zimmcl/EDII_TPFinal/Informe_Final.pdf

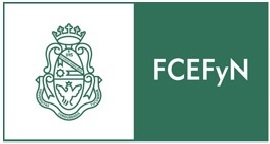
[picture p1: figure]

FA C U LTA D D E C I E N C I A S E X A C TA S ,

### F Í S I C A S Y N AT U R A L E S

E L E C T R Ó N I C A D I G I TA L 2

## C O N T R O L D E P R O X I M I D A D

## M E D I A N T E U S O D E S E N S O R U LT R A S Ó N I C O H C - S R 0 4

## Zimmel Ceccón, Ezequiel José

### email ezequielzimmel@gmail.com

## Docente: Ing. Martín Ayarde

Ú LTM A R E V I S I Ó N : 1 7 D E J U N I O D E 2 0 1 8

## I N F O R M E T R A B A J O F I N A L

índice
1. Descripción general | 3
2. Desarrollo | 4

abstract

Hoy en día existen numerosos dispositivos que utilizan ultrasonidos, tanto en el área industrial, como el la medicina y muchas otras aplicaciones no tan conocidas. En este proyecto vamos a explorar las posibilidades del sensor HC-SR04, un sensor ultrasónico de distancia de bajo costo, usado comúnmente en robots, pero no necesariamente limitado a ese uso. En el circuito de prueba del proyecto utilizaremos un microcontrolador PIC16F887 que medirá el tiempo del pulso ECHO. Después calcularemos la distancia y se mostrará a través de diplays 7-SEG. A su vez, la misma información será transmitida por serie a un ordenador.
El documento desarrolla todas las instancias necesarias para lograr implementar un proyecto empleando microcontroladores PIC. Las instancias del documento abarcan desde el detallado de los elementos a emplear, pasando por la grabación del microcontrolador, hasta la muestra del proyecto montado y funcionando sobre una protoboard.

Ingeniería en Computación, Universidad Nacional de Córdoba, Córdoba, Argentina

2

descripción general | 3
1 | descripción general

## 1.1 Introducción

Los sensores ultrasónicos modernos para la medición de distancias, son de bajo costo y permiten su acoplamiento a sistemas microcontroladores. Estos sensores cuentan con una pequeña bocina emisora del sonido y un micrófono receptor de la señal ultrasónica rebotada por el objeto del cual se desea medir la distancia.
El principio de funcionamiento es el siguiente: a través de la bocina se envían trenes de pulsos de ultrasonido a una frecuencia 40Khz. Esta señal rebota contra el objeto y regresa al sensor, siendo detectada por el micrófono (Figura 1). La distancia se calcula considerando el tiempo (en microsegundos) del ancho del pulso de la señal Echo, y dividida por 58 para obtener el valor en centimetros.

Distancia[cm] = AnchodelpulsoEcho[µs]
58 | (1)

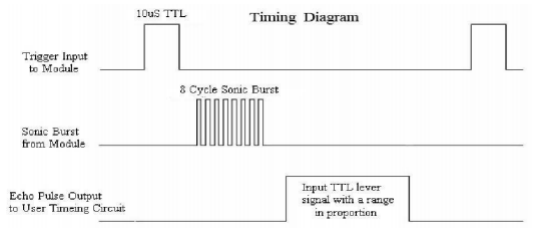
[picture p2: figure]

Figura 1: Funcionamiento

El sensor HC-SR04, (https://cdn.sparkfun.com/datasheets/Sensors/Proximity/HCSR04.pdf) con capacidad de medir distancias entre 2 cms y 4 metros, maneja 2 señales de control conectadas al microcontrolador, en este caso el PIC16F887. La primera es el ’Trigger’, que es un pulso con 10µs (mínimo) de duración que dispara la emisión de 8 pulsos de ultrasonido a través de la bocina, como se muestra en la Figura 1. La segunda señal, llamada ’Echo’, genera un pulso cuya duración es igual al tiempo de respuesta de la señal ultrasónica rebotada por el objeto a medir.

## 1.2 Elementos empleados

Para el desarrollo del proyecto se precisa el uso de:

- Programador PIC y software PICkit con soporte para el microcontrolador.
- Microcontrolador PIC16F887. (http://ww1.microchip.com/downloads/en/DeviceDoc/41291D.pdf)
- Protoboard(s).
- 1 Buzzer piezoelectrico. Hoja de datos. (http://www.farnell.com/datasheets/2171929.pdf)
- 1 sensor ultrasónico HC-SR04. Hoja de datos. (https://docs.google.com/document/d/1Y-yZnNhMYy7rwhAgyL_pfa39RsB-x2qR4vP8saG73rE/edit)
- 3 pulsador Switch.
- Resistencias varias.
- 2 diplay 7-SEG x4 Anodo Común. Hoja de datos. (http://kitsrus.com/pdf/kw4-561.pdf)
- 6 transistores PNP de baja señal. Hoja de datos. (https://www.onsemi.com/pub/Collateral/BC327-D.PDF)
- 1 LED RGB. Hoja de datos. (https://www.kitronik.co.uk/pdf/5mm_RGB_led_common_cathode.pdf)
- 1 módulo USB-UART CP2102. Hoja de datos. (https://www.sparkfun.com/datasheets/IC/cp2102.pdf)

desarrollo | 4
2 | desarrollo

En esta sección se describirá lo que se espera que el sistema haga (Requerimientos), y como fueron implementados dichos requerimientos (Especificaciones). A su vez, se detallaran los cálculos de los elementos pasivos del circuito, y se abordan los pasos necesarios para la grabación del microcontrolador.

## 2.1 Requerimientos y Especificaciones

A partir del siguiente diagrama funcional, se desarrollan las correspondientes subsecciones.

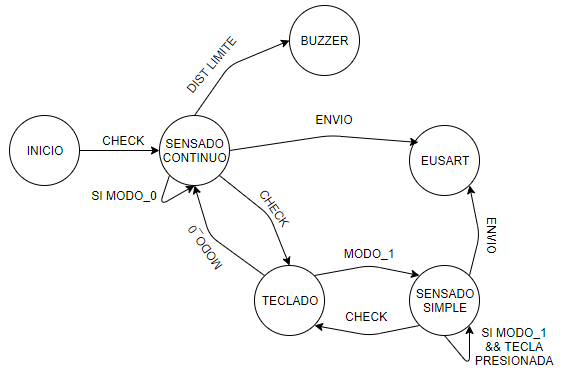
[picture p3: figure]

Figura 2: Funcionamiento

### 2.1.1 Sensado de distancia

Para la adquisición de la distancia se emplea la ecuación 1, mediante el uso de interrupciones por RB0 y TMR0.
Lo primero que se hace es realizar la configuración del registro INTCON (Interrupciones) y OPTION_REG (Flanco de interrupción de RB0 y PS).
MOVLW | B’1 1 0 1 0 0 0 0 ’
MOVWF | OPTION_REG | ; RB0 | por fl a n c o ascenden te . PS 1 : 2
MOVLW | B’1 0 0 1 0 0 0 0 ’
MOVWF | INTCON | ; GIE (ON) , T0IE (OFF ) , INTE (ON)

Se elige interrumpir RB0 por flanco ascendente para detectar el frente del pulso ECHO. A partir de esta interrupción, se inicializa el TMR0 y se habilita dicha interrupción, a los fines de contabilizar los centimetros de distancia al objetivo. Por otro lado, el flanco de interrupción de RB0 se cambia a flanco descendiente, para detectar la cola del pulso ECHO, y a partir de dicho instante deshabilitar la interrupción por TMR0.
Las interrupciones son gestionadas por el vector de interrupción, en donde se chequean las banderas de las interrupciones y se redirecciona a la subrutina de atención correspondiente.

INT_VECTOR
| ; Guardamos el c on te x t o
MOVLW | W_TEMP
SWAPF | STATUS,W
MOVWF | S_TEMP

; Chequeamos banderas de i n t e r r u p ci o n
BTFSC | INTCON, INTF
CALL | RB0_INT
BTFSC | INTCON, T0IF
CALL | TMR0_INT
; Recuperamos el c on te x t o
SWAPF | S_TEMP ,W
MOVWF | STATUS
SWAPF | W_TEMP, F
SWAPF | W_TEMP,W
RETFIE

La subrutina de RB0 chequea el estado actual del Pin de entrada al microcontrolador desde el Pin ECHO del sensor. Si el estado es Alto (1 lógico), inicializa el TMR0, habilita su interrupción y cambia su flanco de interrupción pasando de flanco ascendente a descendente. Por el contrario, si el estado es Bajo (0 lógico), deshabilita el TMR0 y cambia su flanco de interrupción de descendente a ascendente.

RB0_INT
BCF | INTCON, INTF
BTFSS | ECO
GOTO | DETENER_TIMER
; Cargo al TMR0 | para i n t e r r u p ci o n de 58us
MOVLW | . 1 9 8
MOVWF | TMR0
; Habili tamos ( i n i c i a ) el TMR0
BSF INTCON, T0IE
; Reseteamos l o s r e g i s t r o s a s o ci ad o s a l o s di s pl a y s
CLRF | UNIDADES
CLRF | DECENAS
CLRF | CENTENAS
; A c ti v a ci on de RB0 | por fl a n c o de scendien te
BANKSEL OPTION_REG
BCF OPTION_REG, 6
BANKSEL PORTA
RETURN
DETENER_TIMER
; Se de ti ne al TMR0
BCF INTCON, T0IE
; Se le v a n t a l a bandera de ad q ui si ci o n de di s t a n ci a
BSF | ECO_DONE
; A c ti v a ci on de RB0 | por fl a n c o ascenden te
BANKSEL OPTION_REG
BSF OPTION_REG, 6
BANKSEL PORTA
RETURN

Con cada interrupción del TMR0 se incrementan, según correspondan, los registros asociados al almacenaje de la distancia sensada. El valor de carga del TMR0 garantiza que se produzcan interrupciones cada 58µs. El valor se obtiene a partir
del siguiente cálculo: 58µs = | 4

Fosc ∗ (256 − Carga) ∗ PS =

4
8MHz ∗ (256 − 198) ∗ 2

Nota: Los cálculos anteriores son teóricos, en la práctica se ajusto el valor de Carga para mayor exactitud en la medición.

TMR0_INT
BCF | INTCON | , T0IF

MOVLW | . 1 9 8
MOVWF | TMR0
INCF | UNIDADES
MOVLW | 0x0A
SUBWF | UNIDADES,W
BTFSS | STATUS, Z
RETURN
CLRF | UNIDADES
INCF | DECENAS
MOVLW | 0x0A
SUBWF | DECENAS,W
BTFSS | STATUS, Z
RETURN
CLRF | DECENAS
INCF | CENTENAS
MOVLW | 0x0A
SUBWF | CENTENAS,w
BTFSS | STATUS, Z
RETURN
CLRF CENTENAS
RETURN

### 2.1.2 Seteo de distancia máxima

El seteo de la distancia máxima permite al usuario definir la distancia a partir de la cual el sistema dejará de activar la alerta visual y sonora de proximidad. Esto es llevado a cabo por la rutina de chequeo de botones, y en función de que boton es accionado los registros que almacenan la distancia máxima son incrementado o disminuidos.

CHECK_BOTON
BTFSC | PORTD, RD5
GOTO | RD_5
BTFSC | PORTD, RD6
GOTO | RD_6
BTFSC | PORTD, RD7
GOTO | RD_7
RETURN
RD_5
BTFSC | PORTD, RD5
GOTO | RD_5
BSF | SIN_SHOT
RETURN
RD_6
BTFSC | PORTD, RD6
GOTO | RD_6
INCF | MD_UNI, F
BCF | DEC_FLAG, 0
MOVLW | . 1 0
XORWF | MD_UNI,W
BTFSS | STATUS, Z
RETURN
CLRF | MD_UNI
INCF | MD_DEC, F
BCF | DEC_FLAG, 1
MOVLW | . 1 0

XORWF | MD_DEC,W
BTFSS | STATUS, Z
RETURN
CLRF | MD_DEC
INCF | MD_CEN, F
BCF | DEC_FLAG, 2
MOVLW | . 1 0
XORWF | MD_CEN,W
BTFSS | STATUS, Z
RETURN
CLRF CENTENAS
RETURN

RD_7
BTFSC | PORTD, RD7
GOTO | RD_7
BTFSC | DEC_FLAG, 0
RETURN
MOVF | MD_UNI,W
XORLW | . 0
BTFSC | STATUS, Z
GOTO | CHECK_DEC
DECF | MD_UNI, F
RETURN

CHECK_DEC
BTFSC | DEC_FLAG, 1
GOTO | CLR_MD_UNI
MOVLW | . 9
MOVWF | MD_UNI
DECF | MD_DEC, F
MOVLW | 0xFF
XORWF | MD_DEC,W
BTFSS | STATUS, Z
RETURN
BTFSC | DEC_FLAG, 2
GOTO | CLR_MD_DEC
MOVLW | . 9
MOVWF | MD_DEC
DECF | MD_CEN, F
MOVLW | 0xFF
XORWF | MD_CEN,W
BTFSS | STATUS, Z
RETURN
CLR_MD_CEN
BSF | DEC_FLAG, 2
MOVLW | 0x00
MOVWF | MD_CEN
MOVWF | MD_DEC
MOVWF | MD_UNI
RETURN
CLR_MD_DEC
BSF | DEC_FLAG, 1
MOVLW | 0x00
MOVWF | MD_UNI

MOVWF MD_DEC
RETURN
CLR_MD_UNI
BSF | DEC_FLAG, 0
MOVLW | 0x00
MOVWF | MD_UNI
RETURN

### 2.1.3 Despliegue de datos por displays 7-SEG

La multiplexación de los displays 7-SEG, permite mostrar la distancia sensada y la distancia máxima configurada por el usuario. Los valores almancenados en los registros de distancia se encuentran en BCD por lo que, mediante una tabla de conversión, se obtiene el correspondiente valor 7-SEG. A su vez, la subrutina de RETARDO garantiza que el tiempo que permanece encendido cada display, simule que estan todos encendidos.

MOSTRAR
MOVLW | b ’0 0 1 1 1 0 0 0 ’
MOVWF | PORTB
MOVLW | UNIDADES
MOVWF | FSR
MOVF | INDF ,W
CALL | CONVIERTE
BCF | PORTB, 5
MOVWF | PORTA
CALL | RETARDO
BSF | PORTB, 5
INCF | FSR
MOVF | INDF ,W
CALL | CONVIERTE
BCF | PORTB, 4
MOVWF | PORTA
CALL | RETARDO
BSF | PORTB, 4
INCF | FSR
MOVF | INDF ,W
CALL | CONVIERTE
BCF | PORTB, 3
MOVWF | PORTA
CALL | RETARDO
BSF | PORTB, 3
INCF | FSR
MOSTRAR_MD
MOVF | INDF ,W
CALL | CONVIERTE
BCF | PORTC, 5
MOVWF | PORTA
CALL | RETARDO
BSF | PORTC, 5
INCF | FSR
MOVF | INDF ,W
CALL | CONVIERTE
BCF | PORTC, 4
MOVWF | PORTA
CALL | RETARDO
BSF | PORTC, 4

INCF | FSR
MOVF | INDF ,W
CALL | CONVIERTE
BCF | PORTC, 3
MOVWF | PORTA
CALL | RETARDO
BSF | PORTC, 3
RETURN

### 2.1.4 Cambio entre modos de uso

Cuando se preciona la tecla correspondiente (RD5), se pone en 1 la bandera del ’Modo Simple’, que será chequeada en el bloque de rutina principal, accediendo a la rutina SINGLE_SHOT. En esta rutina se habilitan 2 botones, el primero permite hacer una medición de distancia, y el otro pone en 0 la bandera del ’Modo Simple’, recupera el estado previo a este modo y continua con la ejecución contínua del sistema.

SINGLE_SHOT
MOVF | MD_UNI,W
MOVWF | MD_UNI_C
MOVF | MD_DEC,W
MOVWF | MD_DEC_C
MOVF | MD_CEN,W
MOVWF | MD_CEN_C
ESPERA
MOVLW | . 1 0
MOVWF | MD_UNI
MOVWF | MD_DEC
MOVWF | MD_CEN
MOVLW | MD_UNI
MOVWF | FSR
CALL | MOSTRAR_MD
BTFSC | PORTD, RD7
CALL | DISPARO_
BTFSS | PORTD, RD5
GOTO | ESPERA

SALIR_
BTFSC | PORTD, RD5
GOTO | SALIR_
MOVLW | UNIDADES
MOVWF | FSR
MOVF | MD_UNI_C,W
MOVWF | MD_UNI
MOVF | MD_CEN_C,W
MOVWF | MD_CEN
MOVF | MD_DEC_C,W
MOVWF | MD_DEC
BCF | SIN_SHOT
RETURN
DISPARO_
CALL | SENSADO
BTFSC | PORTD, RD7
CALL | MOSTRAR
BTFSC | PORTD, RD7
GOTO | $−3

CALL ENVIAR
RETURN

### 2.1.5 Aviso de proximidad al objeto sensado

Se realiza la comparación, en binario, de la distancia sensada y el valor de distancia máximo ingresado por el usuario. Si la distancia sensada es mayor al máximo, el sistema desactiva todo tipo de alerta (OFF_); en caso contrario, procede de la siguiente manera:

- Calcula el Rango de distancia, haciendo la diferencia entre el valor máximo ingresado por el usuario y un valor mínimo prefijado (en nuestro caso 5).
- A partir del Rango y con un valor prefijado de cantidad de intervalos (en nuestro caso 5), calcula el intervalo menor (representando unidades de distancia [cm]), a partir del cual, mediante suma de si mismo, obtiene los restante puntos de corte. Ej: Si tenemos que la distancia máxima es 50[cm], tendríamos que Rango=(50 − 5)=45[cm], luego el intervalo mínimo es 9[cm], quedando los puntos de corte en [9, 18, 27, 36, 45].
- Con los puntos de cortes ya definidos, se procede a comprar la distancia sensada con cada nivel de corte. Si la distancia es mayor al primer nivel de corte (según ejemplo 9[cm]), se procede a comprar con el segundo nivel de corte (según ejemplo 18[cm]), continuando hasta el último punto de corte. Siguiendo con el ejemplo, en caso de que la distancia sensada sea mayor a 18[cm] pero menor a 27[cm], el sistema accede a una subrutina asociada a ese intervalo, en donde se setean los valores de RETARDO y se activa la correspondiente alerta visual.

COMPARAR_DISTANCIA
CALL | BCD2BIN
MOVF | BCD_CONV,W
SUBWF | MD_BCD_C,W
BTFSS | STATUS, C
GOTO | OFF_
MOVLW | . 5
SUBWF | MD_BCD_C,W
MOVWF | RANGO
MOVWF | TEMP
INCF | INTERVALO, F
MOVLW | . 5
SUBWF | TEMP, F
BTFSC | STATUS, C
GOTO | $−4
DECF | INTERVALO, F
MOVF | INTERVALO,W
ADDLW | . 8
MOVWF | TEMP
MOVLW | . 8
SUBWF | BCD_CONV,W
BTFSS | STATUS, C
GOTO | NIV_5
MOVF | BCD_CONV,W
SUBWF | TEMP,W

BTFSC | STATUS, C
GOTO | NIV_4
MOVF | INTERVALO,W
ADDWF | TEMP, F
MOVF | BCD_CONV,W
SUBWF | TEMP,W
BTFSC | STATUS, C
GOTO | NIV_3
MOVF | INTERVALO,W
ADDWF | TEMP, F
MOVF | BCD_CONV,W
SUBWF | TEMP,W
BTFSC | STATUS, C
GOTO | NIV_2
MOVF | INTERVALO,W
ADDWF | TEMP, F
MOVF | BCD_CONV,W
SUBWF | TEMP,W
BTFSC | STATUS, C
GOTO | NIV_1
MOVF | INTERVALO,W
ADDWF | TEMP, F
MOVF | BCD_CONV,W
SUBWF | TEMP,W
BTFSC | STATUS, C
GOTO | NIV_0

OFF_
BCF | BUZZER
BCF | LED_B
BCF | LED_R
BCF | LED_G
RETURN

NIV_5
BANKSEL PORTC
BSF | BUZZER
BSF | LED_R
RETURN
NIV_4
BANKSEL PORTC
BSF | LED_R
BCF | LED_G
BCF | LED_B
MOVLW | . 1 0
MOVWF | SUP
GOTO | CARGAR_RES
NIV_3
BANKSEL PORTC
BSF | LED_G
BCF | LED_B
BCF | LED_R

MOVLW | . 3 0
MOVWF | SUP
GOTO | CARGAR_RES
NIV_2
BANKSEL PORTC
BSF | LED_G
BCF | LED_B
BCF | LED_R
MOVLW | . 5 0
MOVWF | SUP
GOTO | CARGAR_RES
NIV_1
BANKSEL PORTC
BSF | LED_B
BCF | LED_R
BCF | LED_G
MOVLW | . 7 0
MOVWF | SUP
GOTO | CARGAR_RES
NIV_0
BANKSEL PORTC
BSF | LED_B
BCF | LED_R
BCF | LED_G
MOVLW | . 9 0
MOVWF | SUP
GOTO | CARGAR_RES

CARGAR_RES
MOVLW | . 2 6
MOVWF | MED
MOVLW | . 6 9
MOVWF | INT
CLRF | TEMP
CLRF | INTERVALO
BTFSC | BUZZER
GOTO | SWITCH
BSF | BUZZER
CALL | RETARDO
CALL | RETARDO
RETURN
SWITCH
MOVLW | 0xF8
ANDWF | PORTC
BCF | BUZZER
CLRF | TEMP
CLRF | INTERVALO
CALL | RETARDO_BUZ
RETURN

### 2.1.6 Envío de datos a PC mediante comunicación serie

Lo primero es configurar el periférico para la comunicación. Se realiza una comunicación de 8bits, asíncrona y de alta velocidad (registro TXSTA). Luego se carga el registro SPBRG con un valor que permita, en nuestro caso, un Baud Rate de 9600 considerando que la frecuencia del oscilador está configurada a 8MHz. Dicho valor puede obtenerse mediante tablas simunistradas por el fabricante o mediante la siguiente ecuación:

X =

Fosc
16 ∗ BaudRateDeseado − 1 =

8MHz
16 ∗ 9600 − 1 = 51
; 9 6 0 0 | baudios con Fosc 8MHz
MOVLW | . 5 1
MOVWF | SPBRG
MOVLW | B’0 0 1 0 0 1 0 0 ’
MOVWF | TXSTA

; Cambiar de banco
;BRG 8 b i t s
BCF BAUDCTL, BRG16

Realizada la configuración, solo resta llamar a la subrutina ENVIAR, para transmitir los datos desde el microcontrolar hacia la PC. Durante la transmisión se hace una espera activa hasta que el registro TXREG se vacie, garantizando que la totalidad de los bits fueron transmitidos.

ENVIAR_DATO_TX
BANKSEL TXREG
MOVWF | TXREG
BSF | STATUS, RP0
; Chequeo TSR , espero a que se v a ci e ( 0 )
BTFSS | TXSTA,TRMT
GOTO | $−1
BCF | STATUS, RP0
RETURN

## 2.2 Grabación del PIC

Para realizar la programación se uso la herramienta PICkit 2 y se mapearon los pines entre el programador y el PIC16F887 conforme a la siguiente imagen:

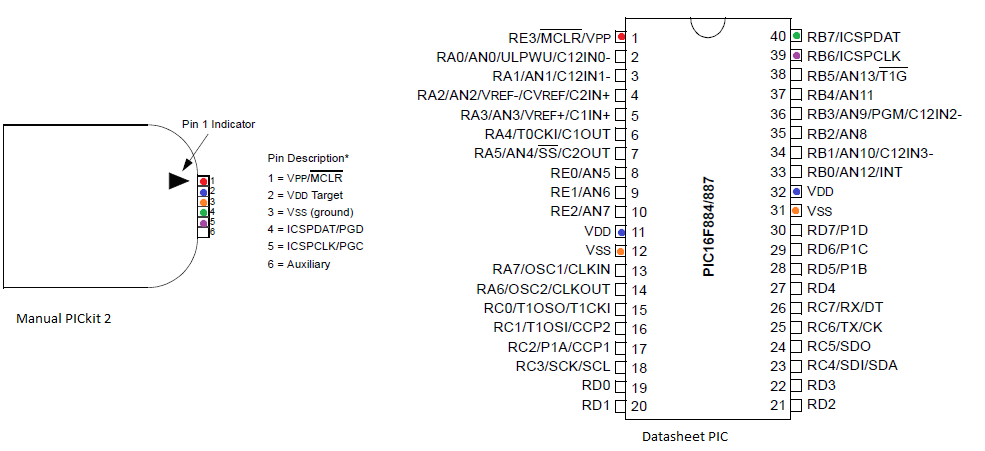
[picture p4: figure]

Figura 3: Mapeo de pines.

Para alimentar al PIC hay que usar solo un par de pines VDD y VSS.

Una vez conectado el programador y ya en la herramienta del PICkit, elegimos el disposito(PIC16F887) y seleccionamos la opción de importación del archivo .hex y grabación.

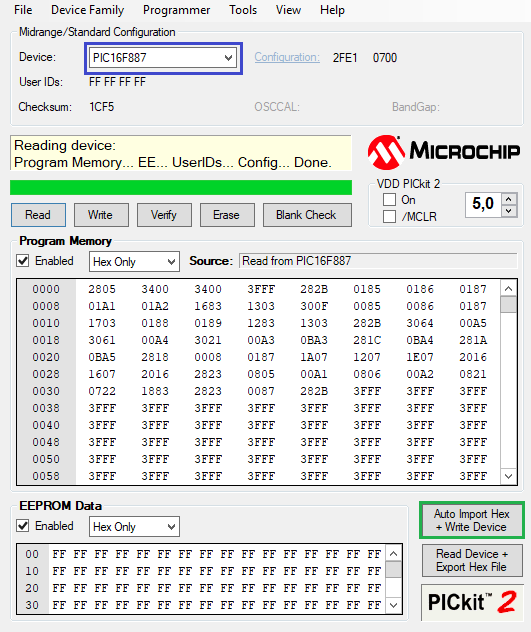
[picture p5: figure]

Figura 4: Grabación del microcontrolador.

## 2.3 Implementación

### 2.3.1 Simulación

A los fines de probar si el código desarrollado cumple con los requerimientos, se implemento todo el circuito empleando la herramienta Proteus. Con el documento se adjunta el archivo .pdsprj del simulador.
La siguiente figura muestra como se disponen e interconectan los diversos elementos que conforman el circuito.

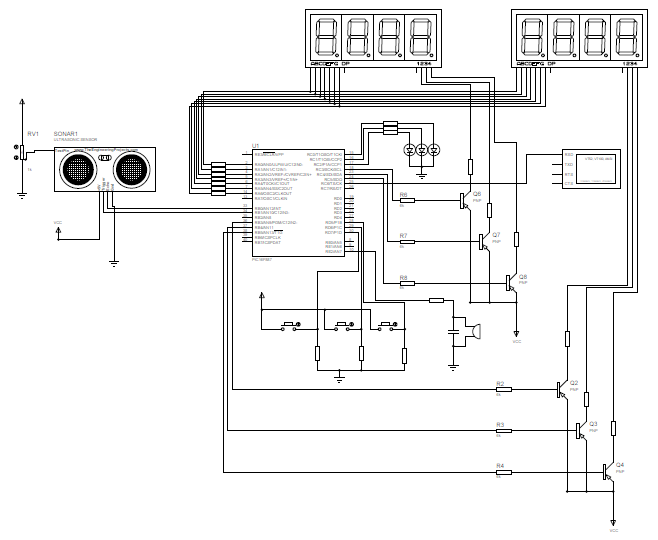
[picture p6: figure]

Figura 5: Esquematico del circuito.

Nota: Las resistencias conectadas en los colectores de los transistores, son unicamente a los fines que la simulación en Proteus funcione. En el montaje físico dichas resistencias no se utilizan.

En esta etapa lo que resta es el cálculo del valor de la resistencia limitadora de corriente asociada a cada LED (RC) y el valor de la resistencia conectada en la base de cada transistor (RB).

A partir de la Figura 6 y aplicando la ley de Kirchhoff de la tensión, obtenemos las siguientes ecuaciones:

Vcc = Vce + Vdiodo + Ic ∗ Rc | (2)

Luego Rc es:

Rc =

Vcc − Vce − Vdiodo
Ic

=

5,9V − 0,2V − 2V
10mA | = 370Ω

Si tomamos como valor de hFE 100, el valor de Rb lo calculamos a partir de la siguiente ecuación:

Vcc = Vbe + Ib ∗ Rb | (3)

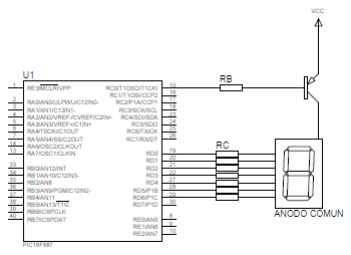
[picture p7: figure]

Figura 6: Esquema para el cálculo de RB y RC.

Luego Rb es:

Rb =

(Vcc − Vbe) ∗ 100
Ib

=

(5,9V − 0,7V) ∗ 100
70mA | ' 7,4kΩ

El valor de las resistencias conectadas al LED RGB se obtienen restando a la tensión de alimentación la caida de tensión en el led y diviendo dicho resultado por 20mA (valor del fabricante):

Rd =

Vcc − Vdiodo
20mA =

5,9V − 2V
20mA = 195Ω

### 2.3.2 Montaje

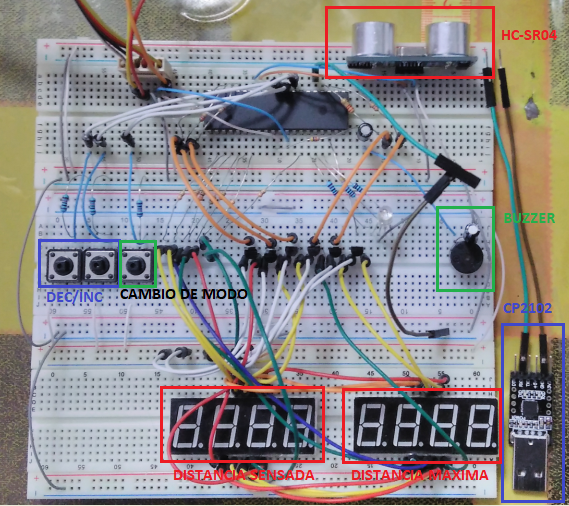
[picture p8: figure]

Figura 7: Montaje del circuito.

Junto con los archivos .asm, .hex, .pdsprj y el presente documento, se adjunta un video del proyecto funcionando.
