zimmcl/EDII_TPFinal/(list of files, drawings)

Other design files:
Simulacion_TPF_ZimmelEzequiel.pdsprj
